marcos4503/lego-creative-hub/This-Repository/source.png

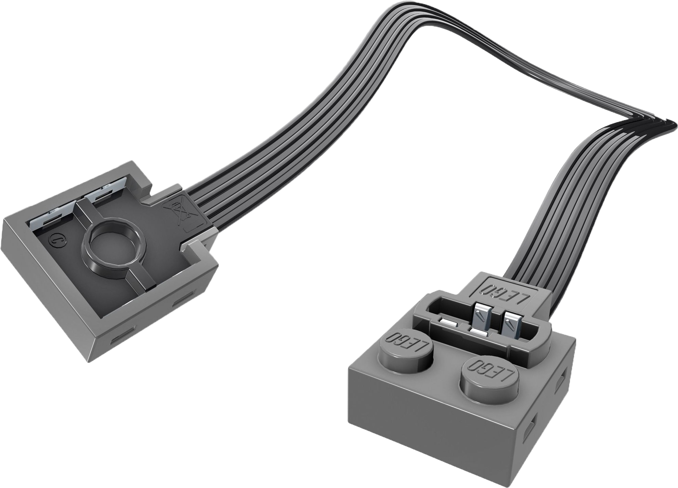
This-Repository/source.png
